sprakashb/Universal_VFO_BFO_for_HamRig/Si5351DDSSimple.pdf

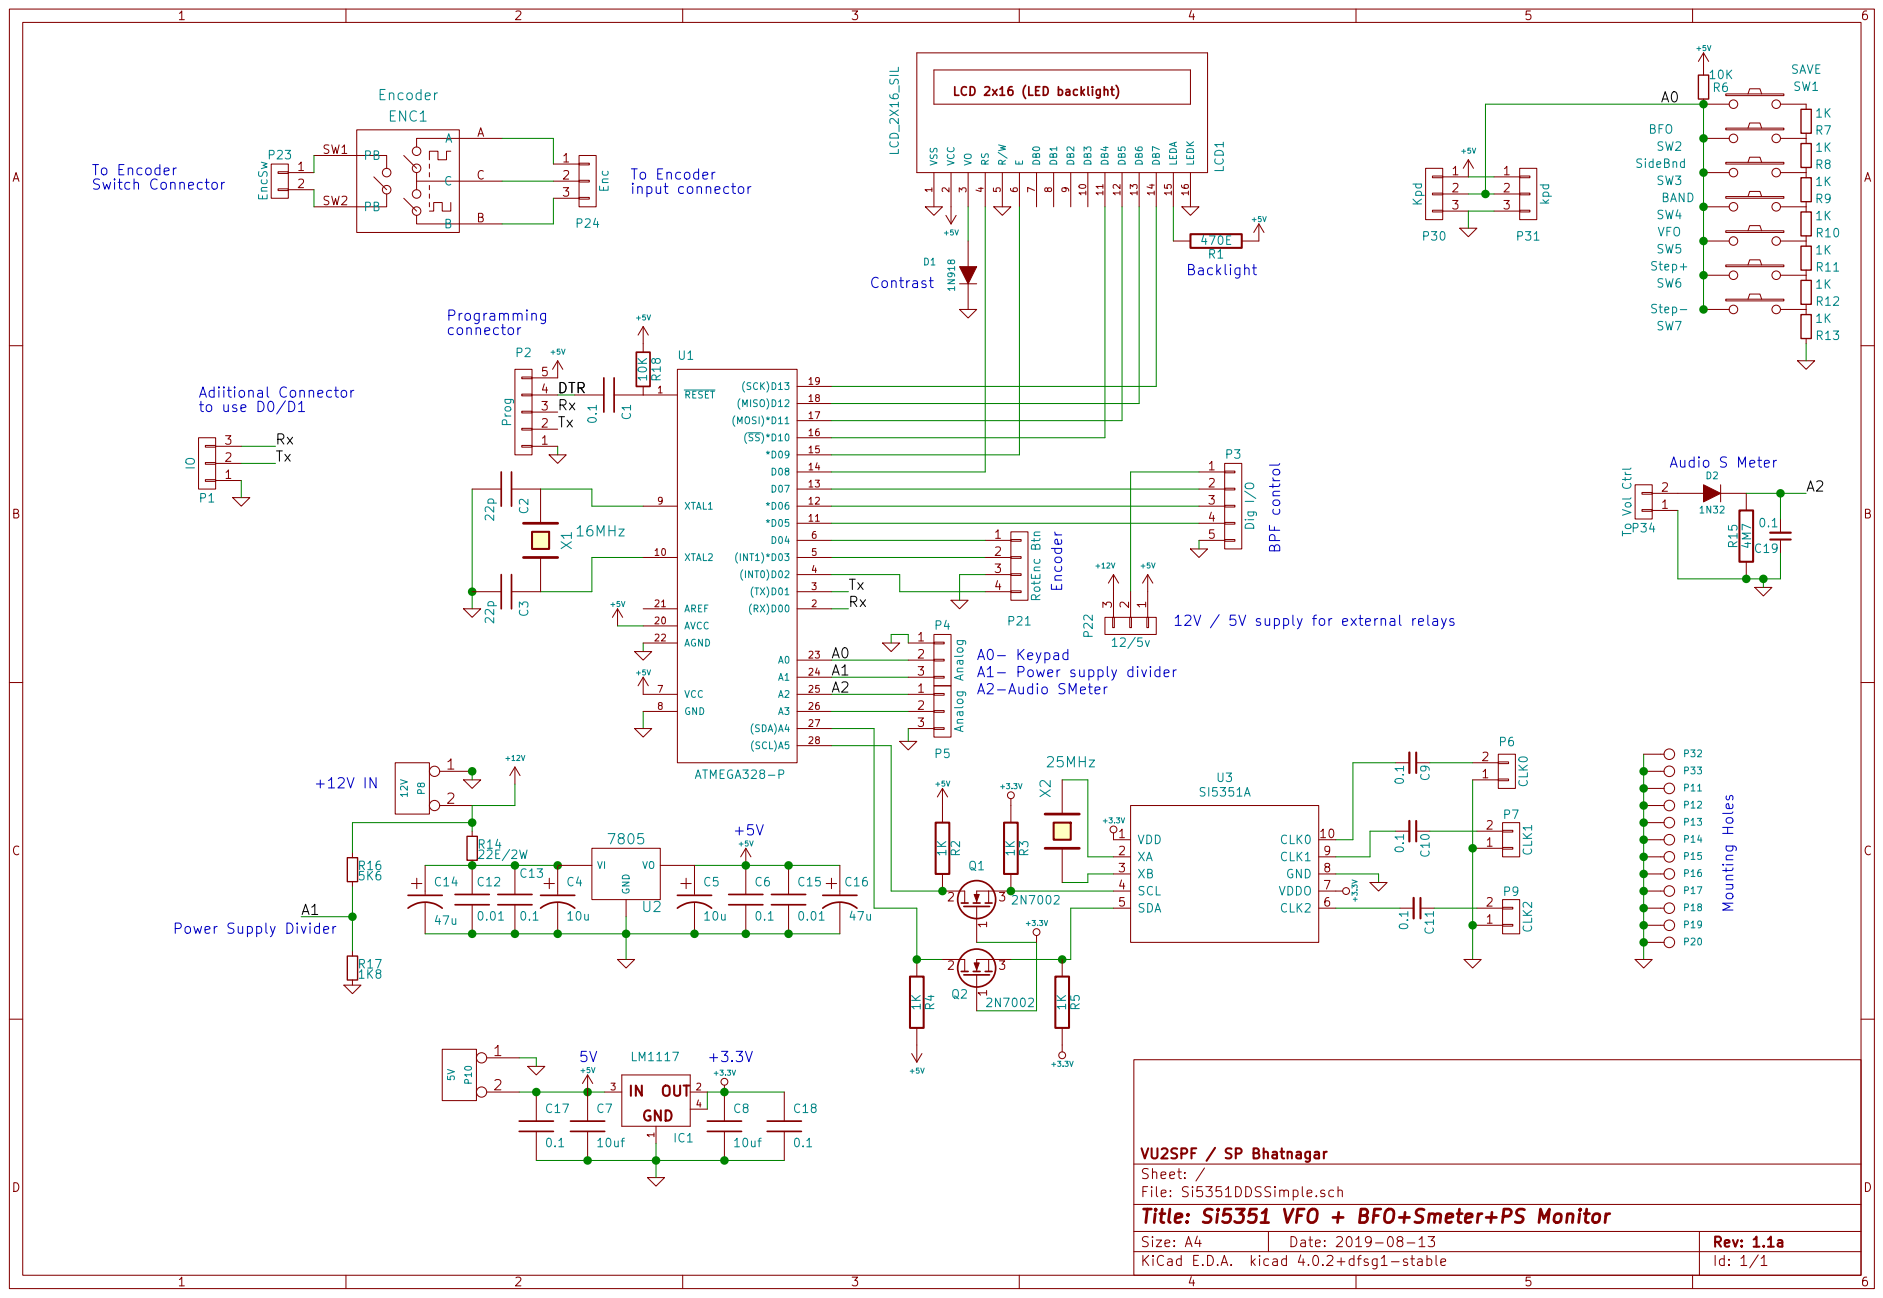
[picture p1: page 1]

LCD 2x16 (LED backlight) VSS

input connector To Encoder Switch Connector

2 To Vol Ctrl P34 Audio S Meter R16

12V / 5V supply for external relays Encoder 5V

File: Si5351DDSSimple.sch Sheet: / VU2SPF / SP Bhatnagar

Id: 1/1 Title: Si5351 VFO + BFO+Smeter+PS Monitor
